colton-frank21/JD-Project-2/Project 2 Submission/Enclosure_Design_Files/Final_Bopit_Parts/Enclosure_Pic.png

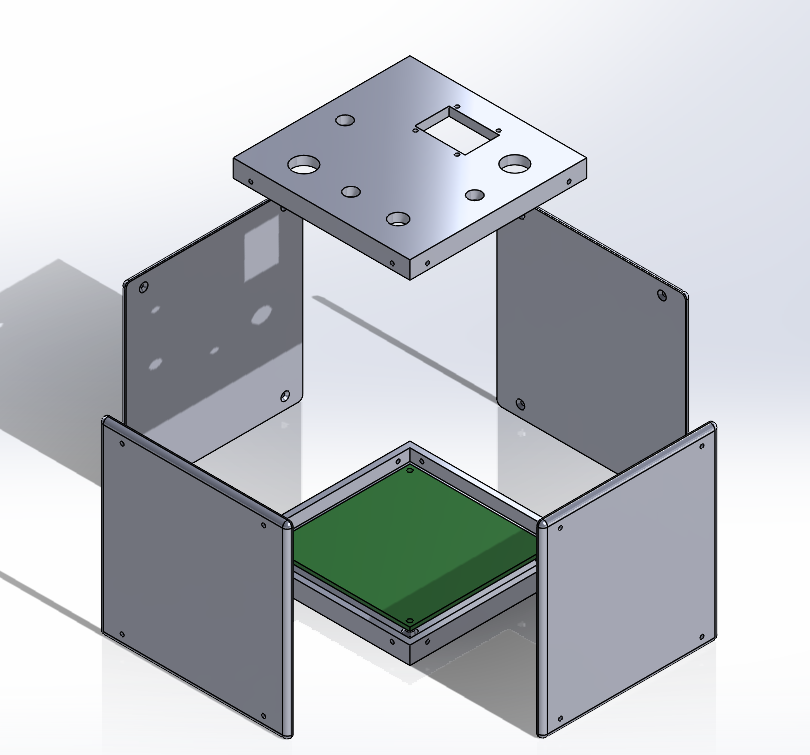
Project 2 Submission/Enclosure_Design_Files/Final_Bopit_Parts/Enclosure_Pic.png
