colton-frank21/JD-Project-2/README.md

This repository will be junior design project 2, the bob-it project.
