colton-frank21/JD-Project-2/Project 2 Submission/ReadMe.txt

This is the completed bop-it project for Junior Design Spring 2025

Code files can be found in folder named Bopit_Project_Code

3d model and STL files for enclosure can be found in folder named Enclosure_Design_Files

PCB files can be found in folder named Upsilon_Bopit_76.mmX76.2mm
