colton-frank21/JD-Project-2/Project 2 Submission/Enclosure_Design_Files/Final_Bopit_Parts/Bopit_Enclosure.SLDASM

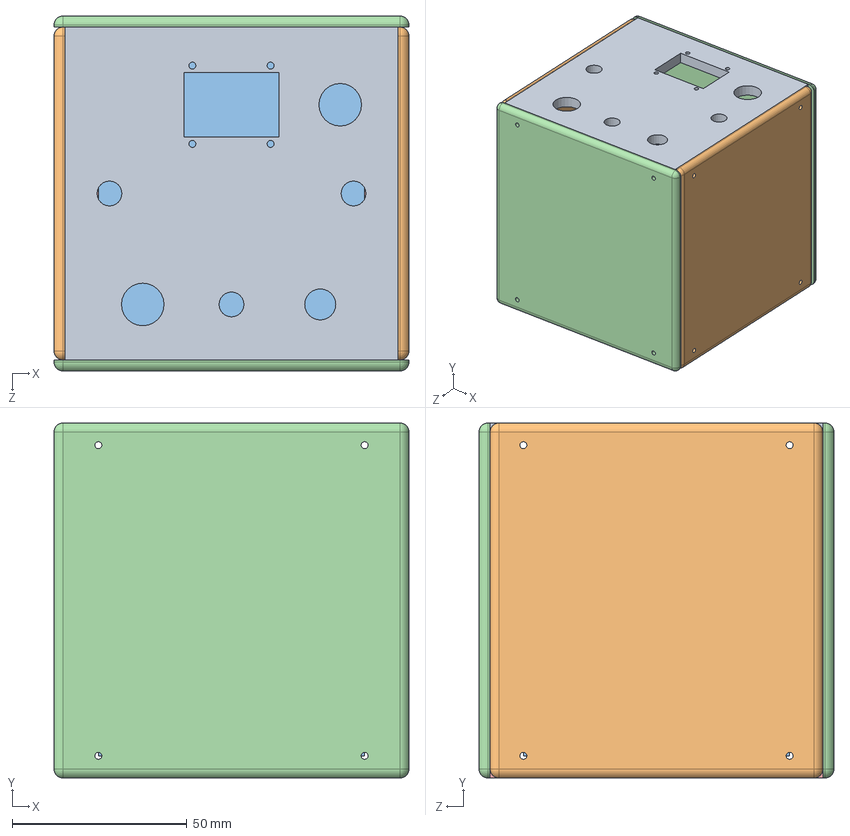
[picture p9: CAD file, 2025-04-17]
Project 2 Submission/Enclosure_Design_Files/Final_Bopit_Parts/Bopit_Enclosure.SLDASM
101.6 x 101.6 x 101.6 mm
Bottom_Panel
F_B_panel x 2
Rough_PCB_Shape
L_R_panels x 2
Top_Panel
