colton-frank21/JD-Project-2/Project 2 Submission/Enclosure_Design_Files/Final_Bopit_Parts/Rough_PCB_Shape.SLDPRT

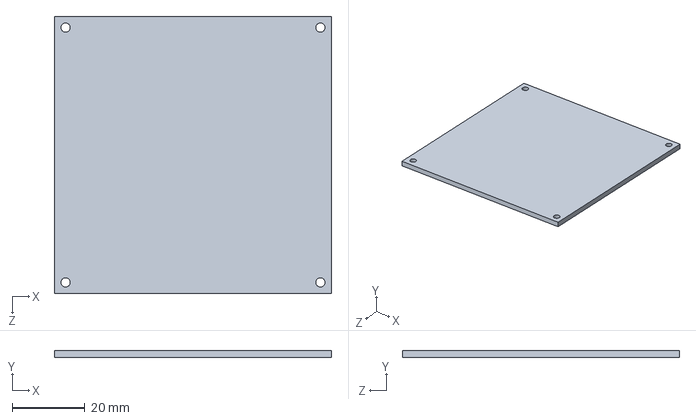
[picture p10: CAD file, 2025-04-17]
Project 2 Submission/Enclosure_Design_Files/Final_Bopit_Parts/Rough_PCB_Shape.SLDPRT
76.2 x 2.01 x 76.2 mm
