colton-frank21/JD-Project-2/Project 2 Submission/Enclosure_Design_Files/Final_Bopit_Parts/Hole_Test.SLDPRT

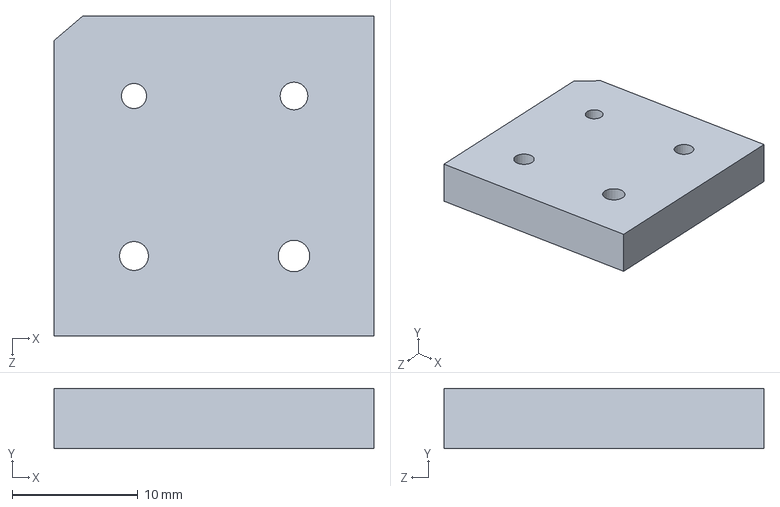
[picture p11: CAD file, 2025-04-17]
Project 2 Submission/Enclosure_Design_Files/Final_Bopit_Parts/Hole_Test.SLDPRT
25.4 x 4.76 x 25.4 mm
