colton-frank21/JD-Project-2/Project 2 Submission/Enclosure_Design_Files/Final_Bopit_Parts/L_R_panels.SLDPRT

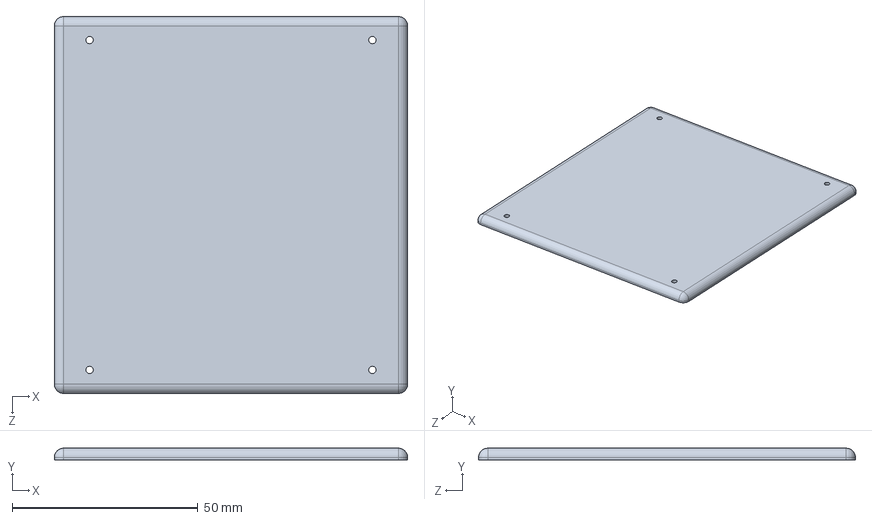
[picture p12: CAD file, 2025-04-17]
Project 2 Submission/Enclosure_Design_Files/Final_Bopit_Parts/L_R_panels.SLDPRT
95.2 x 3.17 x 101.6 mm
