colton-frank21/JD-Project-2/Project 2 Submission/Enclosure_Design_Files/Final_Bopit_Parts/F_B_panel.SLDPRT

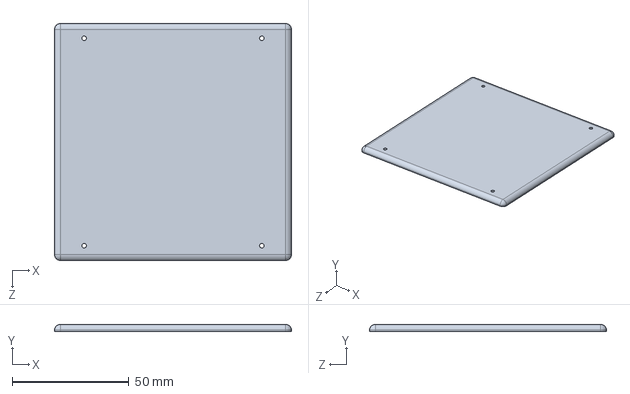
[picture p14: CAD file, 2025-04-17]
Project 2 Submission/Enclosure_Design_Files/Final_Bopit_Parts/F_B_panel.SLDPRT
101.6 x 3.17 x 101.6 mm
