colton-frank21/JD-Project-2/Project 2 Submission/Enclosure_Design_Files/Final_Bopit_Parts/Top_Panel.SLDPRT

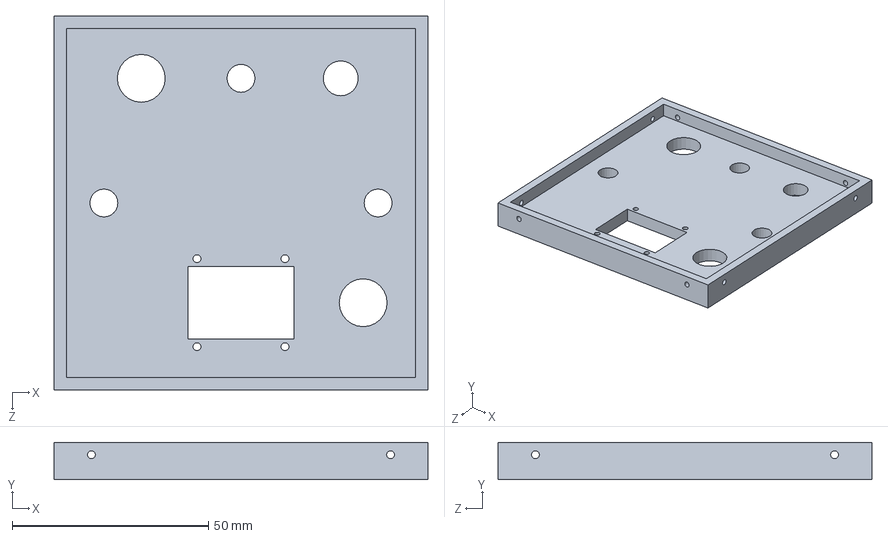
[picture p15: CAD file, 2025-04-17]
Project 2 Submission/Enclosure_Design_Files/Final_Bopit_Parts/Top_Panel.SLDPRT
95.2 x 9.53 x 95.2 mm
