colton-frank21/JD-Project-2/(list of files, cad)

Other CAD files:
Project 2 Submission/Enclosure_Design_Files/Final_Bopit_Parts/Bottom_Panel.STL
Project 2 Submission/Enclosure_Design_Files/Final_Bopit_Parts/F_B_panel.STL
Project 2 Submission/Enclosure_Design_Files/Final_Bopit_Parts/Hole_Test.STL
Project 2 Submission/Enclosure_Design_Files/Final_Bopit_Parts/L_R_panels.STL
Project 2 Submission/Enclosure_Design_Files/Final_Bopit_Parts/Top_Panel.STL
