colton-frank21/JD-Project-2/(list of files, drawings)

Other design files:
Project 2 Submission/Upsilon_Bopit_76.mmX76.2mm/Upsilon_Bopit_76.mmX76.2mm/PCB1.PcbDoc
Project 2 Submission/Upsilon_Bopit_76.mmX76.2mm/Upsilon_Bopit_76.mmX76.2mm/Sheet1.SchDoc
Project 2 Submission/Upsilon_Bopit_Project.PcbDoc
