colton-frank21/JD-Project-2/(commit log)

2025-04-17 Code For the Bopit
    Forgot to push the code for bop it project since it was looking at wrong folder
    [Bopit_project.ino]
2025-04-17 All of the files for project 2
    [Bopit_Enclosure.SLDASM, Bottom_Panel.SLDPRT, Bottom_Panel.STL, F_B_panel.SLDPRT, F_B_panel.STL, Hole_Test.SLDPRT, Hole_Test.STL, L_R_panels.SLDPRT]
2025-04-17 Final submission of all files
    [Bopit_Enclosure.SLDASM, Bottom_Panel.SLDPRT, Bottom_Panel.STL, F_B_panel.SLDPRT, F_B_panel.STL, Hole_Test.SLDPRT, Hole_Test.STL, L_R_panels.SLDPRT]
